ohhaashis/Aircraft-Leak-Detection-System-/hardware/BOM.csv

Item | Quantity | Specification | Purpose | Status
Pressure sensor | 2 | HK2016 0-1 MPa 0.5-4.5 V G1/4 | Inlet/outlet pressure | Have
Flow sensor | 2 | DIJIANG OF06ZAT G3/4 30-3000 L/h NPN pulse | Inlet/outlet flow | Have
PZT disc | 4 | 50 x 2.6 mm 40 kHz ultrasonic transducer | Acoustic leak sensing | Have
AD620 amplifier module | 4 | AD620 + offset + 7660 module | PZT amplification (gain ~50) | Check count
STM32F411CEU6 Black Pill | 1 | WeAct STM32F411 | AE sampling and features | Have
ESP32 dev board | 1 | ESP32-WROOM DevKit | Pressure/flow and laptop link | Have
ADS1115 module | 1 | 16-bit 4-channel I2C ADC | Pressure reading | Buy
Diaphragm pump | 1 | 12 V 60 W 5 L/min self-priming | Circulation | Have
PWM motor speed controller | 1 | 12-40 V 10 A | Pump speed | Have
12 V power supply | 1 | 12 V >= 8 A SMPS | Pump and sensors | Check
Inline fuse + holder | 1 | 10 A | Pump circuit protection | Buy
LM2596 buck module | 1 | 12 V -> 5 V | Sensor/AD620 supply | Buy
AMS1117-3.3 module | 1 | 3.3 V regulator | Clean analog 3.3 V (optional) | Buy
Resistor 1 kohm | 16 | 1/4 W | AE series (12) + pressure filter (2) + flow filter (2) | Buy
Resistor 1 Mohm | 8 | 1/4 W | AE input bias | Buy
Resistor 10 kohm | 13 | 1/4 W | AE bias (8) + flow pull-ups (2) + dividers (3) | Buy
Resistor 20 kohm | 3 | 1/4 W | Pressure and rail dividers | Buy
Capacitor 2.2 nF C0G/film | 4 | 50 V | AE AC coupling | Buy
Capacitor 1 nF | 4 | ceramic | AE anti-alias | Buy
Capacitor 100 nF | 10 | ceramic | Filters and decoupling | Buy
Capacitor 10 uF | 6 | electrolytic | Module decoupling | Buy
Diode 1N4148 | 16 | signal diode | AE input clamps | Buy
BAT54S | 4 | dual Schottky SOT-23 | ADC input clamps | Buy
Ferrite clip | 2 | for 5-7 mm cable | Pump wire noise | Buy
Steel saddle block | 4 | 70 x 50 x 10 mm with 12 mm x 5 mm groove | PZT mounting | Workshop
Hose clamps | 8+ | worm-drive | Saddles and drilled-hole leaks | Have/Buy
Shielded audio cable | 4 runs | single core + shield | PZT wiring | Buy
Measuring jug | 1 | 500 mL+ graduated | Flow calibration and leak rate | Buy
Drip tray / sheet | 1 | large | Oil safety | Buy
ISO VG32 hydraulic oil | as needed |  | Working fluid | Buy
