ohhaashis/Aircraft-Leak-Detection-System-/(commit log)

2026-10-27 Complete project: README, docs, report (PDF/DOCX), firmware, ML pipeline, hardware
    [BOM.csv]
2026-10-27 Add STM32 AE firmware (compiles, maths verified vs Python reference); ESP32 compile-checked; docs and report updated
2026-10-31 Add 'pressure/flow' to Nishant Thamman's focus
2026-10-31 Pin scipy for Windows, ignore venv
2026-10-31 Add CLAUDE.md project context, ESP32 v2.1
2026-10-31 Dashboard: sensor health, leak-probability chart, tare/record/silence
    - Sidebar controls: tare (Z), silence alarm (A0 until the alarm clears),
    start/stop recording to data/raw in the same format as logger.py
    - Sensor-health panel for ESP32/STM32 links, P1/P2, Q1/Q2, PZT1-4,
    using the limits from check_runs.py
    - Leak-probability chart (last 60 s, threshold line, alarm periods)
    - Alarm streak counts only windows with new data, so a stalled link
    cannot raise or hold an alarm
    - check_runs.py: main code moved under __main__ so it can be imported
    - CLAUDE.md: update built / still-to-build lists
    Tested headless with a fake ESP32 and in replay mode; not yet on hardware.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
    [check_runs.py, dashboard.py]
2026-10-31 ESP32 firmware v2.1: K-factors in flash, flow nulling (N), settings (P)
    - K,<ch>,<v> saves the K-factor in flash (Preferences); loaded at boot,
    defaults to 1.2 with a "not calibrated" note until set
    - N: averages Q1/Q2 for 30 s (pump on, leaks closed) without pausing the
    CSV rows, then scales K2 so Q2 matches Q1 and saves it; fails with a
    message below 100 valid samples; warns if K2 moves more than 10 %
    - P: prints K1, K2, pressure zeros, 5 V rail and ADS1115 status
    - All status lines start with '#'; 43-column CSV row unchanged
    - CLAUDE.md: firmware status updated
    Built and tested on the PC with stand-in libraries (CSV output identical
    to v2); not yet compiled with the ESP32 core or r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
    [leak_daq.ino]
2026-10-31 Update CLAUDE.md status: bench-test switch, report draft, stale docs
    Record the prepared fake-sensor bench test (expected values), the
    Software/ML report draft, what is still pending commit, and which docs
    no longer match the code.
